EloySerrudo/EMDR-Project/(commit log)

2025-02-28 Updated and corrected support verification platform for Teensy 4.0, ESP32, and Raspberry Pi Pico
2025-03-03 Increase devices; correct LED amount and improve error handling
2025-05-05 Creada nueva rama para interfaz unificada.
2025-05-05 GUI Adaptada
    Cambios a la nueva GUI
2025-05-05 Funcionan ambas ventanas por separado y con switch buttons.
2025-05-07 Editados los scripts para mejorar la interfaz
    - Se crearon los archivos necesarios para crear y utilizar la base de datos
    - main.py ya integraga los 2 widgets.
    - emdr_controller mejorado, usando otros layouts, ya no grid.
    - sensor monitor convertido a qwidget
    - container, adaptado para recibir switches.
2025-05-07 Funcional con toda la interfaz
2025-05-17 Reducido a 58 leds. Actualziado las ganancias de PPG y EOG. Y los ficheros adicionas del Circular Buffer.
2025-05-17 Reducción a 58 leds. Aumento de información en la base de datos. Añadido el detector de pulsos. Adaptada la interfaz para resolución de 1366 x 768.
2025-05-17 Evitar guardar la base de datos.
2025-05-18 Añadido cambio de tira de led.
2025-05-18 Funciona el cambio de tiras y mejorado la posición del contador y speed.
2025-05-29 Corregido las bases de datos y añadido un nuevo código para recuperar los datos.
2025-05-29 Archivo de vision de los datos en Destop
2025-05-29 Añadido la ventana intermedia después de login, añadido ventana para recupara info de los pacientes, añadido género en la base de datos.
2025-05-29 Mejorado la página de saludo
2025-05-29 Login adaptado para laptop
2025-05-30 se cambió el color de 3 ventanas
2025-06-03 Creados archivos auxiliares para crear tonos, íconos o colores.
2025-06-03 Cambio de nombre de ícono. Añadidos nuevos tonos y scripts en tools.
2025-06-03 Mejroados las primeras ventanas ed la GUI
2025-06-03 Adaptados los 3 scripts para usar los tonos WAV
2025-06-04 Quitados varios prints de sonido
2025-06-04 Mejorado tamaños del Sensor Monitor
2025-06-04 Mejoras en widgets de control antes de cambio de estilo.
2025-06-06 Mejorado el EMDR Control Panel
2025-06-09 Sensor monitor Funcional
2025-06-10 Mejoras en el Control Panel y objetos button y selector.
2025-06-11 comienzo de análisis de los datos.
2025-06-11 Borrado de base de datos
2025-06-11 Mejorado la recuperación de datos BPM.
2025-06-11 Mejora de cierre global
2025-06-12 Therapist dashboard envía el nombre del terapeuta. Desde dashboard se va control panel y se puede regresar con un botón nuevo.
2025-06-12 Mejorado controlador emdr y sensor.
2025-06-12 Cierre de control panel corregido.
2025-06-13 Mejorados base de datos y su manipulación.
2025-06-16 Tool de eog monitor
2025-06-17 Inicio de filtro EOG mejorado.
2025-06-25 Mejoras en la interfaz y filtro de la señal de EOG
2025-06-26 Añadida ventana de pruebas de sensores.
2025-06-30 Añadida primera prueba step fixation y el análisis offline, además de un filtro mejorado para offline.
2025-07-02 Añadido protocolo de persecución lineal y análisis off line del pulso.
2025-07-05 Mejorado offline para purebas eog
2025-07-17 Add function of new sensor script
2025-07-18 Cambio de nombre de RealTimeFilter a OnlinePPGFilter
2025-07-18 Adaptado el monitreo de los sensores similar a los scripts de pruebas de PPG y EOG.
2025-07-18 Cambio de carpeta de los archivos relacionados con el terapeuta.
2025-07-19 Añadida opción de añadir paciente.
2025-07-21 Ahora añadir paciente añade fecha de registro.
2025-07-21 Funciona añadir paciente y borrar paciente. Editado los gráficos en sensor_monitor.
2025-07-22 Mejorado Patient Manager y Control Panel.
2025-07-22 Añadido detector de pulsos
2025-07-23 Sensor mónitor mejorado añadiendo un área de pulsaciones.
2025-07-24 Mejoras en la tabla sesiones, administración de pacientes y en el control panel.
2025-07-24 Añadido botón para borrar la sesión.
2025-07-25 Mejorado la actualización de cantidad de sesiones por paciente al crear y eliminar.
2025-07-31 Mejora de la tabla derecha. Mostrar maximizado el control panel
2025-08-04 Modificado la recuperación de los datos de las señales de la base de datos
2025-08-04 Añadida la opción de editar los datos de los pacientes.
2025-08-04 Añadida edición de las sesiones.
2025-08-13 Mejorado el Slider para ver en session_details_dialog y añadido un PPG ofline filter.
2025-08-14 Añadido procesamiento offline de ppg y ventana de análisis offline
2025-08-15 corregido ventana que muestra el pulso
2025-08-15 Ahora en las sesiones se ve el BPM.
2025-08-20 Añadido funciones para editar comentarios y objetivos en la base de datos. Mejorado el dialogo de detalle de la sesion añadiendo el pulso y su evolución y otras ediciones.
2025-11-18 Cambiado de lugar pulse_test_window
2025-11-18 Añadido run.py y corregidas las importaciones de las ventanas.
